kleieg/Duplo_Zug/images/Controller_white.jpeg

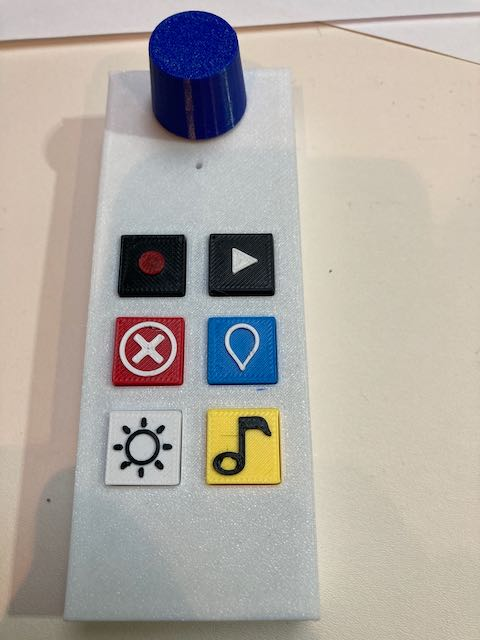
images/Controller_white.jpeg
