kleieg/Duplo_Zug/hardware/DuploTrainController NG/5 Buttons an ADC.xlsx

R0 | 2.2 | k |  | Rges in k | Rn in k | Uadc in V | Function | R E12 in k | Uadc in V | delta | ADC Value | Button
x1 | 0.15 |  | R1 | 0.4 | 0.4 | 0.495 | Record | 0.43 | 0.540 | 0.540 | 669.6882129 | Record
x2 | 0.3 |  | R2 | 0.9 | 0.6 | 0.99 | Play | 0.62 | 1.066 | 0.527 | 1323.323077 | Play
x3 | 0.45 |  | R3 | 1.8 | 0.9 | 1.485 | Stop | 0.91 | 1.555 | 0.489 | 1929.846154 | Stop
x4 | 0.6 |  | R4 | 3.3 | 1.5 | 1.98 | Water | 1.5 | 2.017 | 0.463 | 2503.915194 | Water
x5 | 0.75 |  | R5 | 6.6 | 3.3 | 2.475 | LED Cycle | 3.3 | 2.490 | 0.472 | 3090.285714 | Light
x6 | 0.9 |  | R5 | 19.8 | 13.2 | 2.97 | Sound Cycle | 13 | 2.969 | 0.480 | 3685.653916 | Sound
open |  |  |  |  |  | 3.3 | alle offen |  | 3.300 | 0.331 | 4096
 | Ucc | 3.3
 | Imax | 1mA
