kleieg/Duplo_Zug/hardware/DuploTrainController NG/DuploTrainController NG.csv

Id | Designator | Footprint | Quantity | Designation | Supplier and ref
1 | R5 | R_0805_2012Metric_Pad1.20x1.40mm_HandSolder | 1 | 1.5K
2 | R3 | R_0805_2012Metric_Pad1.20x1.40mm_HandSolder | 1 | 620
3 | R1 | R_0805_2012Metric_Pad1.20x1.40mm_HandSolder | 1 | 2,2k
4 | SW3 | SW_SPST_Omron_B3FS-101xP | 1 | Stop
5 | U1 | MODULE_ESP32-S3_SUPERMINI_SMD | 1 | ESP32-S3_SUPERMINI_SMD
6 | SW1 | SW_SPST_Omron_B3FS-101xP | 1 | Record
7 | SW0 | RotaryEncoder_Bourns_Vertical_PEC12R-3x17F-Sxxxx | 1 | Speed / Wakeup
8 | C1 | C_0805_2012Metric | 1 | 100n
9 | SW2 | SW_SPST_Omron_B3FS-101xP | 1 | Play
10 | R2 | R_0805_2012Metric_Pad1.20x1.40mm_HandSolder | 1 | 430
11 | R6 | R_0805_2012Metric_Pad1.20x1.40mm_HandSolder | 1 | 3.3k
12 | R4 | R_0805_2012Metric_Pad1.20x1.40mm_HandSolder | 1 | 910
13 | SW4 | SW_SPST_Omron_B3FS-101xP | 1 | Water
14 | SW6 | SW_SPST_Omron_B3FS-101xP | 1 | Sound Cycle
15 | SW5 | SW_SPST_Omron_B3FS-101xP | 1 | LED Cycle
16 | R7 | R_0805_2012Metric_Pad1.20x1.40mm_HandSolder | 1 | 13k
