kleieg/Duplo_Zug/hardware/Case/Controller-V1.5-Knöpfe-2.3mf

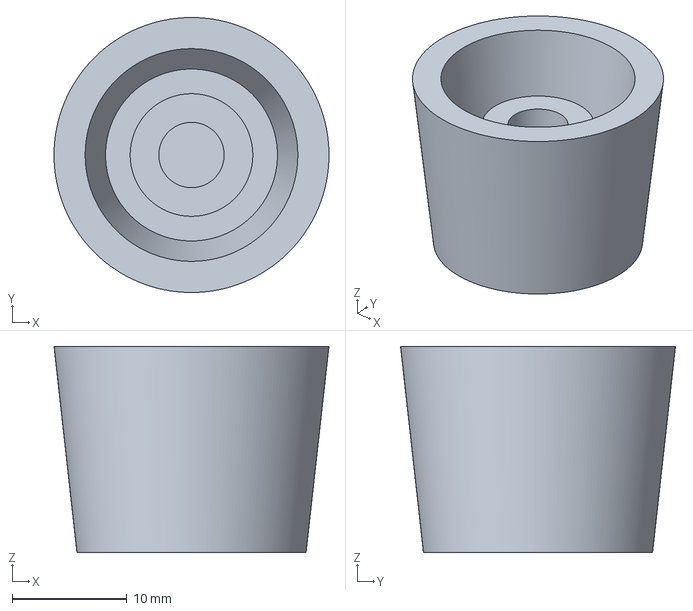
[picture p4: CAD file, 2026-03-19]
hardware/Case/Controller-V1.5-Knöpfe-2.3mf
24.0 x 24.0 x 18.0 mm
