kleieg/Duplo_Zug/hardware/Case/Controller-V1.5-Knöpfe-1.3mf

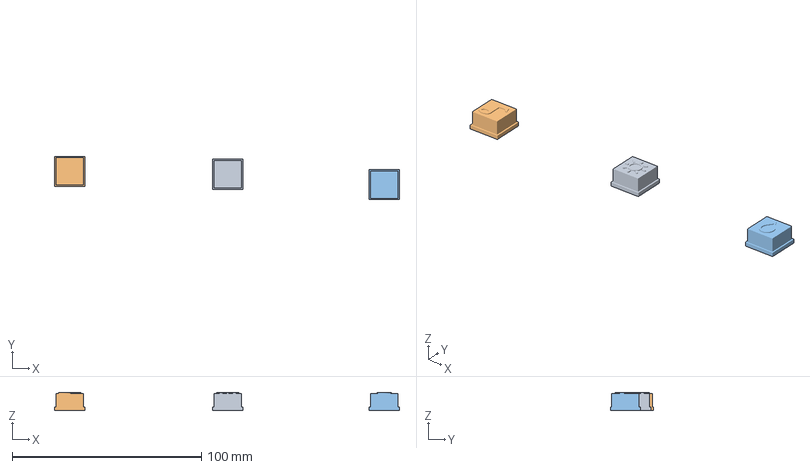
[picture p5: CAD file, 2026-03-19]
hardware/Case/Controller-V1.5-Knöpfe-1.3mf
182.4 x 23.0 x 9.59 mm
Knopf_Licht.stl
Knopf_Musik.stl
Knopf_Wasser.stl
