kleieg/Duplo_Zug/hardware/Case/Controller-V1.5-Duplo.3mf

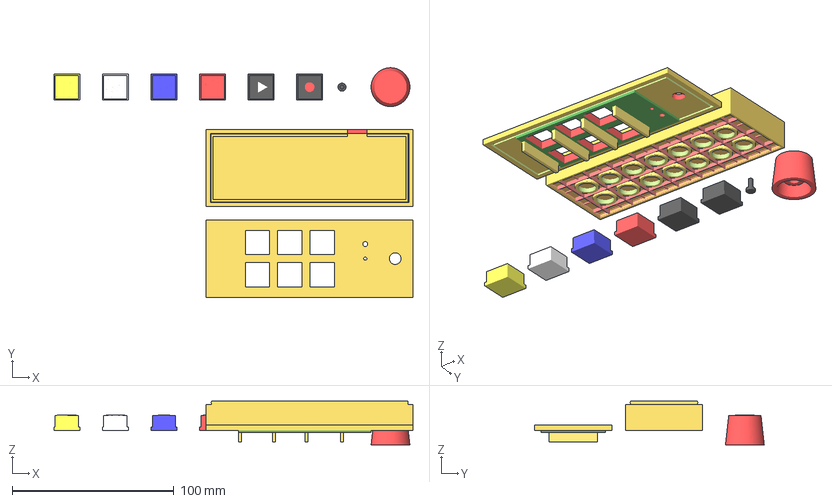
[picture p6: CAD file, 2026-03-19]
hardware/Case/Controller-V1.5-Duplo.3mf
221.9 x 141.9 x 27.0 mm
