kleieg/Duplo_Zug/hardware/Case/Controller-V1.5.3mf

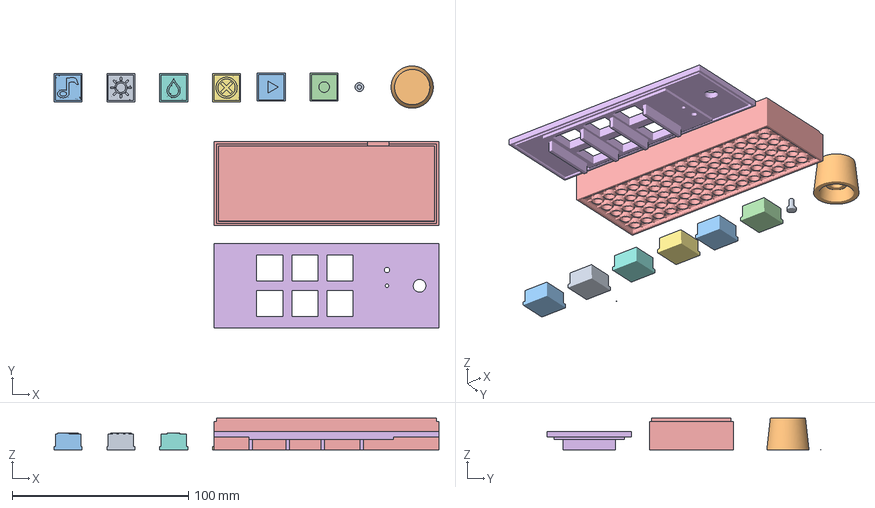
[picture p7: CAD file, 2026-03-08]
hardware/Case/Controller-V1.5.3mf
218.7 x 155.5 x 18.0 mm
