kleieg/Duplo_Zug/hardware/Case/Knopf_Wasser.stl

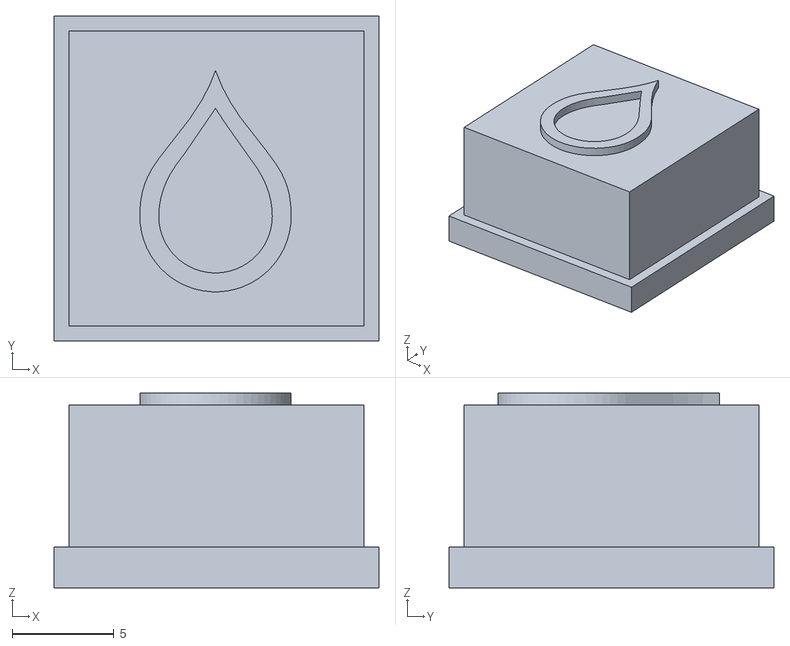
[picture p8: CAD file, 2026-03-08]
hardware/Case/Knopf_Wasser.stl
16.0 x 16.0 x 9.59
