kleieg/Duplo_Zug/hardware/Case/Knopf_Musik.stl

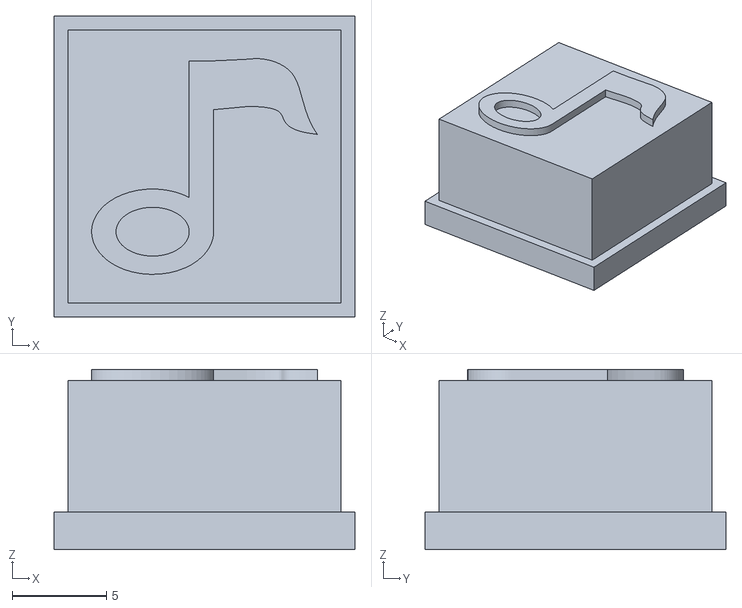
[picture p9: CAD file, 2026-03-08]
hardware/Case/Knopf_Musik.stl
16.0 x 16.0 x 9.58
