kleieg/Duplo_Zug/(list of files, cad)

Other CAD files:
hardware/Case/Knopf_Stop.stl
hardware/Case/Knopf_Licht.stl
hardware/Case/Controller.scad
