kleieg/Duplo_Zug/hardware/DuploTrainController NG/DuploTrainController NG.kicad_pcb

## KiCad design hardware/DuploTrainController NG/DuploTrainController NG.kicad_pcb (2026-03-08)

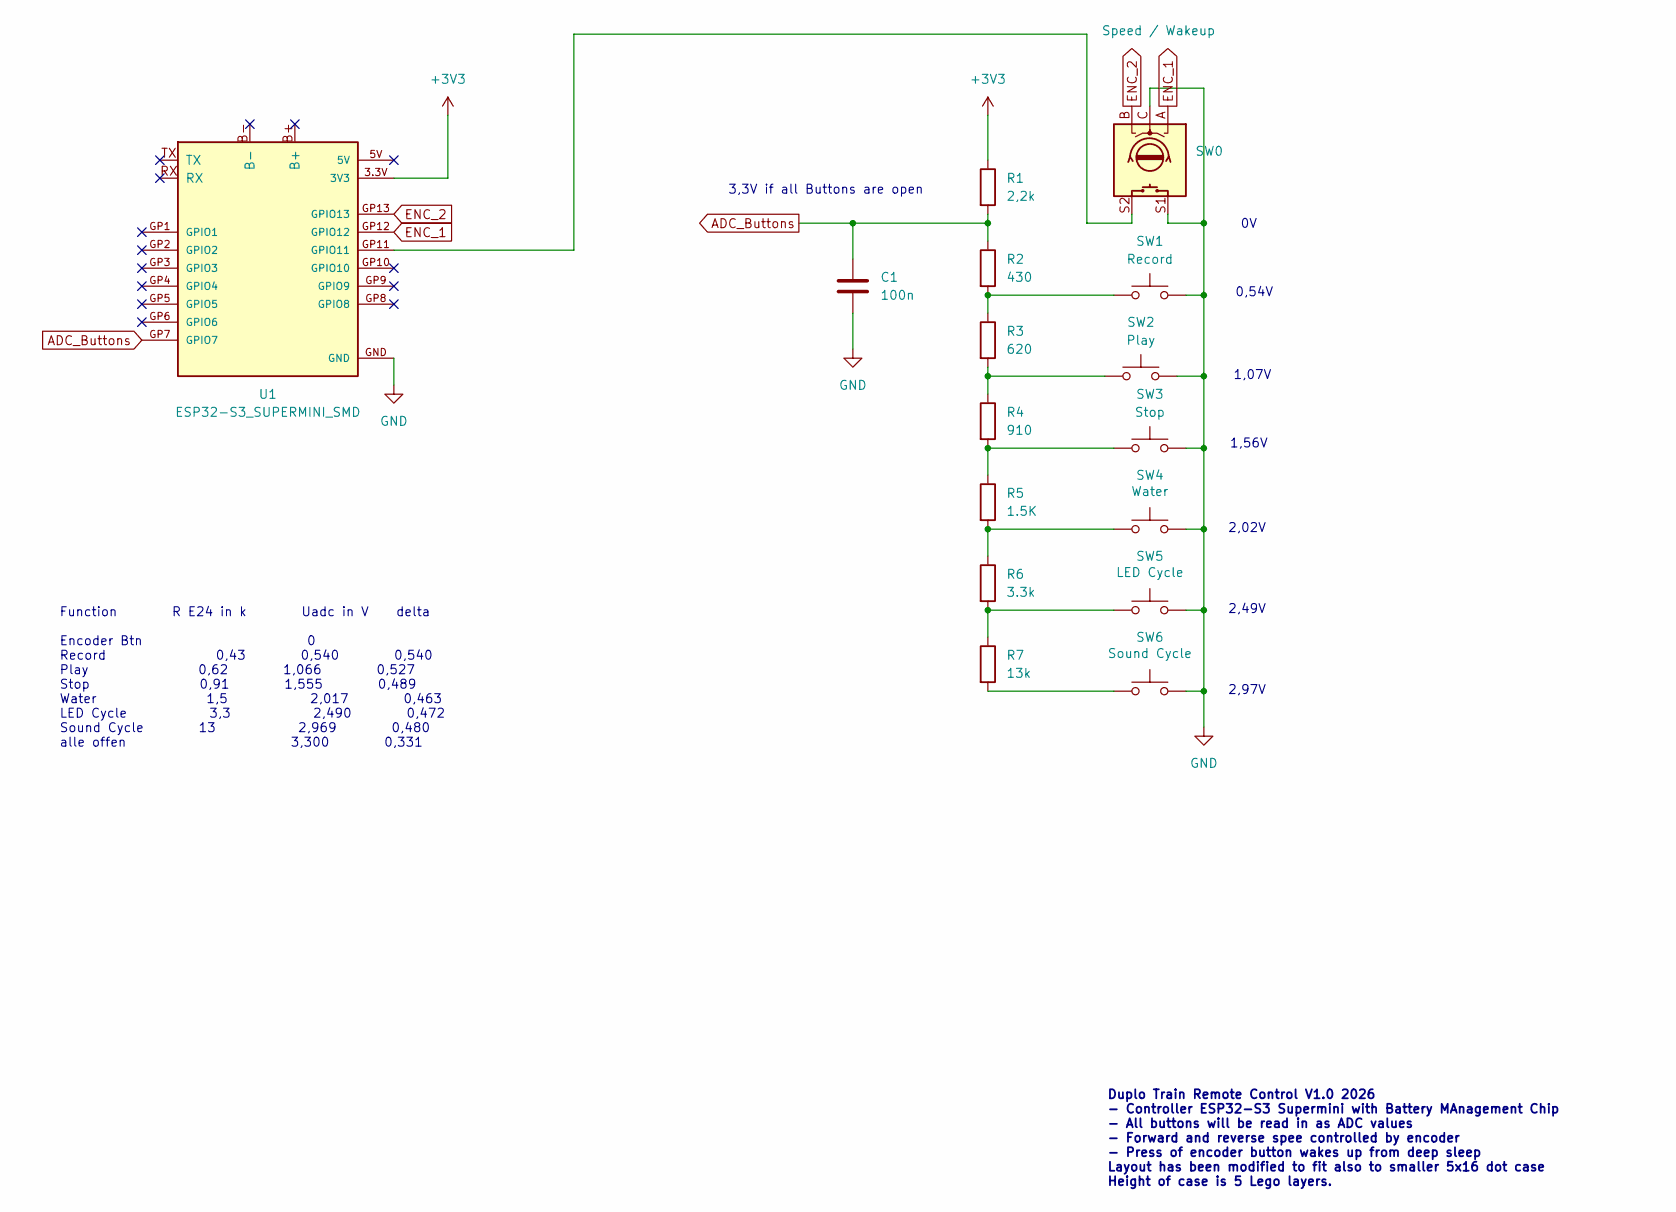
[picture p10: schematic DuploTrainController NG.kicad_sch]

Parts:
C1: 100n; C_0805_2012Metric
R1: 2,2k; R_0805_2012Metric_Pad1.20x1.40mm_HandSolder
R2: 430; R_0805_2012Metric_Pad1.20x1.40mm_HandSolder
R3: 620; R_0805_2012Metric_Pad1.20x1.40mm_HandSolder
R4: 910; R_0805_2012Metric_Pad1.20x1.40mm_HandSolder
R5: 1.5K; R_0805_2012Metric_Pad1.20x1.40mm_HandSolder
R6: 3.3k; R_0805_2012Metric_Pad1.20x1.40mm_HandSolder
R7: 13k; R_0805_2012Metric_Pad1.20x1.40mm_HandSolder
SW0: Speed / Wakeup; RotaryEncoder_Bourns_Vertical_PEC12R-3x17F-Sxxxx
SW1: Record; SW_SPST_Omron_B3FS-101xP
SW2: Play; SW_SPST_Omron_B3FS-101xP
SW3: Stop; SW_SPST_Omron_B3FS-101xP
SW4: Water; SW_SPST_Omron_B3FS-101xP
SW5: LED Cycle; SW_SPST_Omron_B3FS-101xP
SW6: Sound Cycle; SW_SPST_Omron_B3FS-101xP
U1: ESP32-S3_SUPERMINI_SMD; MODULE_ESP32-S3_SUPERMINI_SMD

Connections:
+3V3: R1.1, U1.3.3V (3V3)
ADC_Buttons: C1.1, R1.2, R2.1, U1.GP7 (GPIO7)
ENC_1: SW0.A, U1.GP12 (GPIO12)
ENC_2: SW0.B, U1.GP13 (GPIO13)
GND: C1.2, SW0.C, SW0.S1, SW1.2, SW2.2, SW3.2, SW4.2, SW5.2, SW6.2, U1.GND
unnamed: R2.2, R3.1, SW1.1
unnamed: R3.2, R4.1, SW2.1
unnamed: R4.2, R5.1, SW3.1
unnamed: R5.2, R6.1, SW4.1
unnamed: R6.2, R7.1, SW5.1
unnamed: R7.2, SW6.1
unnamed: SW0.S2, U1.GP11 (GPIO11)

Notes on the sheet:
2,02V
0,54V
2,49V
1,07V
Duplo Train Remote Control V1.0 2026 - Controller ESP32-S3 Supermini with Battery MAnagement Chip - All buttons will be read in as ADC values - Forward and reverse spee controlled by encoder - Press of encoder button wakes up from deep sleep Layout has been modified to fit also to smaller 5x16 dot 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
3,3V if all Buttons are open
2,97V
Function R E24 in k Uadc in V delta Encoder Btn 0 Record 0,43 0,540 0,540 Play 0,62 1,066 0,527 Stop 0,91 1,555 0,489 Water 1,5 2,017 0,463 LED Cycle 3,3 2,490 0,472 Sound Cycle 13 2,969 0,480 alle offen 3,300 0,331
1,56V

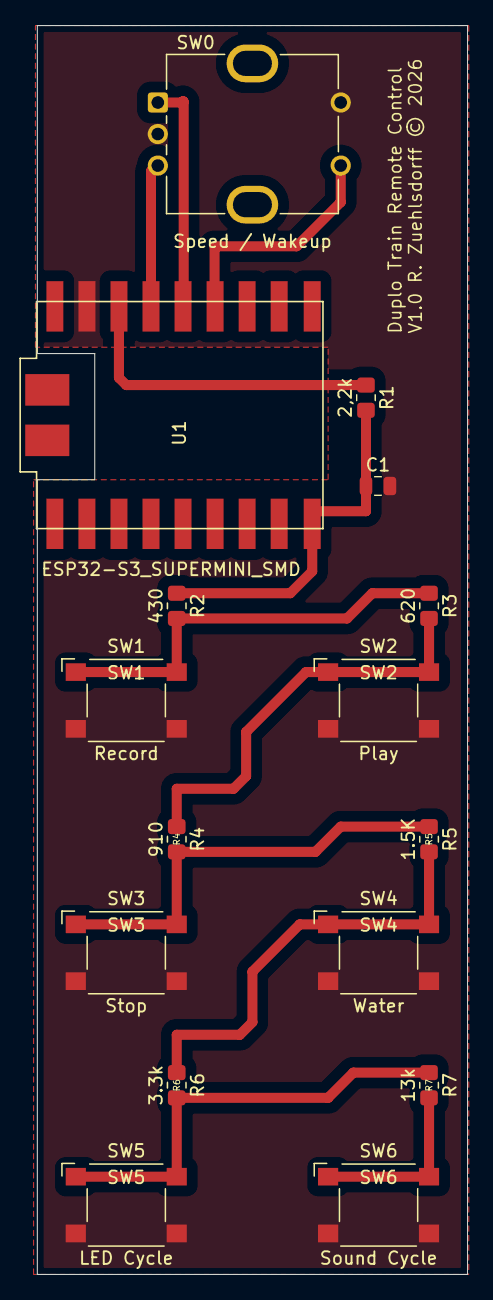
[picture p11: board DuploTrainController NG.kicad_pcb from above]

Board: 2 copper layers, 34.1 x 99.0 mm, 16 parts (0 on the bottom side), 12 nets.
