kleieg/Duplo_Zug/src/DuploHub.cpp

/**
 * @file DuploHub.cpp
 * @brief Implementation of the DuploHub class for LEGO DUPLO Train Hub control on ESP32.
 *
 * This file provides the implementation for the DuploHub class, which encapsulates all
 * functionality required to control a LEGO DUPLO Train Hub using the ESP32 platform.
 *
 * Features:
 * - Thread-safe command queuing for motor, LED, and sound control
 * - Optimized BLE task responsiveness and reduced latency
 * - Automatic connection management and recovery
 * - Dual-core FreeRTOS architecture for robust, responsive operation
 * - Modular callback system for sensors and events
 *
 * @author Ralf Zühlsdorff
 * @date 2025
 *
 * @copyright
 * MIT License
 *
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
 * THE SOFTWARE IS PROVIDED "AS IS", WITHOUT WARRANTY OF ANY KIND, EXPRESS OR
 * IMPLIED, INCLUDING BUT NOT LIMITED TO THE WARRANTIES OF MERCHANTABILITY,
 * FITNESS FOR A PARTICULAR PURPOSE AND NONINFRINGEMENT. IN NO EVENT SHALL THE
 * AUTHORS OR COPYRIGHT HOLDERS BE LIABLE FOR ANY CLAIM, DAMAGES OR OTHER
 * LIABILITY, WHETHER IN AN ACTION OF CONTRACT, TORT OR OTHERWISE, ARISING FROM,
 * OUT OF OR IN CONNECTION WITH THE SOFTWARE OR THE USE OR OTHER DEALINGS IN THE
 * SOFTWARE.
 */

#include "Arduino.h"
#include "DuploHub.h"
#include "LegoinoCommon.h"
#include "esp_timer.h"
#include "esp_err.h"
#include "esp_task_wdt.h"

//  #define DEBUG // Enable debug logging
#undef DEBUG // Enable debug logging
#include "debug.h"

// Initialize static instance pointer
DuploHub *DuploHub::instance = nullptr;

namespace
{
    // Color must stay unchanged this long before it is reported. Short enough that a tile is
    // registered at full speed (was 250 ms: tiles were missed and reactions came too late);
    // increase if reflective surfaces cause false tile detections.
    constexpr uint64_t COLOR_SETTLE_DELAY_US = 80000; // 80 ms debounce window
    // Color sensor input mode: 0 = COLOR (classifies any surface into a color index, also carpet,
    // floor, nothing), 1 = C TAG ("color tag", presumably the hub's own action tile detection).
    // C TAG reports one event per action tile (color, then 0xff) and nothing on carpet/floor, so
    // it is far more robust; its events bypass the debounce (see staticColorSensorCallback()).
    // 0 restores the plain COLOR mode with the debounce.
    constexpr uint8_t COLOR_SENSOR_MODE = 1;
    // TEST diagnostics: log every raw color sensor message and what the debounce emits or
    // suppresses (same color as the last stable one). Set to false to disable.
    constexpr bool COLOR_RAW_DIAG = false;
    // The DUPLO hub silently drops a command that arrives while it is still processing the
    // previous one (seen on hardware with 20 ms spacing: random loss of stop/sound/LED commands
    // and sensor activations). Normally the BLE task waits for the hub's acknowledgement
    // (see processCommandQueue()); this fixed pause only applies to commands the hub never
    // acknowledges (hub name) and to unknown/skipped commands.
    constexpr uint32_t COMMAND_PACING_MS = 200;
    // Maximum wait for the hub's acknowledgement of a command (observed: 40-110 ms). After the
    // timeout the BLE task continues, so it is never slower than the fixed pacing.
    constexpr uint32_t ACK_TIMEOUT_MS = 250;
    // Maximum time the BLE task waits for a new command before doing its housekeeping.
    constexpr uint32_t COMMAND_WAIT_MS = 50;
    // After connecting, the hub announces its built-in devices one by one. A device must be
    // announced before it can be activated (Legoino silently ignores unknown ports).
    constexpr uint32_t DEVICE_ATTACH_TIMEOUT_MS = 2000;
    constexpr uint32_t BLE_TASK_WDT_TIMEOUT_S = 15;    // task watchdog timeout for the BLE task
    constexpr UBaseType_t COMMAND_QUEUE_LENGTH = 10;   // main loop -> BLE task
    constexpr UBaseType_t RESPONSE_QUEUE_LENGTH = 100; // BLE task -> main loop (sensor bursts)

    /**
     * @brief Build a timestamped command object for the BLE worker queue.
     * @param type Command type to assign to the new queue item.
     * @return Initialized `HubCommand` containing the current timestamp.
     */
    HubCommand createHubCommand(CommandType type)
    {
        HubCommand cmd{};
        cmd.type = type;
        cmd.timestamp = esp_timer_get_time();
        return cmd;
    }

    // Shared state used to debounce the color sensor callback before emitting events
    portMUX_TYPE colorTimerMutex = portMUX_INITIALIZER_UNLOCKED;
    esp_timer_handle_t colorStabilityTimer = nullptr;
    int pendingColor = -1;
    int pendingRawColor = -1;
    int lastStableColor = -1;
}

/**
 * @brief Create the color stability debounce timer on first use.
 *
 * The timer delays emission of color sensor events by `COLOR_SETTLE_DELAY_US`, ensuring that only
 * stable readings reach the main application. The function is safe to call repeatedly; it merely
 * returns once initialization has succeeded.
 *
 * @return True when the timer handle exists and can be armed.
 */
bool DuploHub::ensureColorTimerInitialized()
{
    if (colorStabilityTimer != nullptr)
    {
        return true;
    }

    DEBUG_LOG("Created color stability timer ");
    esp_timer_create_args_t timerArgs = {};
    timerArgs.callback = &DuploHub::colorStabilityTimerCallback;
    timerArgs.dispatch_method = ESP_TIMER_TASK;
    timerArgs.name = "color_stability";
    timerArgs.skip_unhandled_events = true;

    esp_err_t err = esp_timer_create(&timerArgs, &colorStabilityTimer);
    if (err != ESP_OK)
    {
        DEBUG_LOG("ERROR: Failed to create color stability timer (err=%d)", err);
        colorStabilityTimer = nullptr;
        return false;
    }

    return true;
}

/**
 * @brief Default constructor for DuploHub.
 *
 * Resets all state variables. The motor is always driven on the DUPLO `MOTOR` port.
 */
DuploHub::DuploHub() : hubMACAddress(""),
                       connectionState(false), connectingState(false),
                       connectionMutex(nullptr), commandQueue(nullptr), responseQueue(nullptr),
                       bleTaskHandle(nullptr),
                       onConnectedCallback(nullptr), onDisconnectedCallback(nullptr),
                       detectedColorCallback(nullptr), detectedSpeedCallback(nullptr),
                       detectedVoltageCallback(nullptr)
{
    instance = this; // Set static instance pointer
}

/**
 * @brief Destructor for DuploHub.
 *
 * Cleans up FreeRTOS resources and resets the static instance pointer.
 */
DuploHub::~DuploHub()
{
    cleanupFreeRTOS();
    if (instance == this)
    {
        instance = nullptr; // Clear static instance pointer
    }
}

/**
 * @brief Initialize FreeRTOS objects (mutexes and queues) for thread-safe operation.
 *
 * Creates mutexes and queues for command and response handling.
 */
void DuploHub::initFreeRTOS()
{
    // Create mutex for thread-safe access to connection state
    connectionMutex = xSemaphoreCreateMutex();
    if (connectionMutex == nullptr)
    {
        DEBUG_LOG("ERROR: Failed to create connection mutex");
    }

    // Create command queue for thread-safe communication
    ackSemaphore = xSemaphoreCreateBinary();
    if (ackSemaphore == nullptr)
    {
        DEBUG_LOG("ERROR: Failed to create acknowledgement semaphore");
    }

    commandQueue = xQueueCreate(COMMAND_QUEUE_LENGTH, sizeof(HubCommand));
    if (commandQueue == nullptr)
    {
        DEBUG_LOG("ERROR: Failed to create command queue");
    }

    responseQueue = xQueueCreate(RESPONSE_QUEUE_LENGTH, sizeof(HubResponse));
    if (responseQueue == nullptr)
    {
        DEBUG_LOG("ERROR: Failed to create response queue");
    }

    DEBUG_LOG("DuploHub: FreeRTOS objects initialized");
}

/**
 * @brief Clean up FreeRTOS objects (mutexes and queues).
 *
 * Deletes all created mutexes and queues and stops the BLE task if running.
 */
void DuploHub::cleanupFreeRTOS()
{
    // Stop BLE task if running
    stopBLETask();

    // Delete mutex
    if (connectionMutex != nullptr)
    {
        vSemaphoreDelete(connectionMutex);
        connectionMutex = nullptr;
    }

    if (ackSemaphore != nullptr)
    {
        vSemaphoreDelete(ackSemaphore);
        ackSemaphore = nullptr;
    }

    // Delete command queue
    if (commandQueue != nullptr)
    {
        vQueueDelete(commandQueue);
        commandQueue = nullptr;
        DEBUG_LOG("DuploHub: Command queue cleaned up");
    }

    // Cleanup response queue
    if (responseQueue != nullptr)
    {
        vQueueDelete(responseQueue);
        responseQueue = nullptr;
        DEBUG_LOG("DuploHub: Response queue cleaned up");
    }

    DEBUG_LOG("DuploHub: FreeRTOS objects cleaned up");
}

/**
 * @brief Update the connection state variables in a thread-safe manner.
 * @param connected True if the hub is connected.
 * @param connecting True if the hub is in the process of connecting.
 */
void DuploHub::updateConnectionState(bool connected, bool connecting)
{
    if (connectionMutex != nullptr)
    {
        xSemaphoreTake(connectionMutex, portMAX_DELAY);
        connectionState = connected;
        connectingState = connecting;
        xSemaphoreGive(connectionMutex);
    }
}

/**
 * @brief Initialize the DuploHub (thread-safe, can be called from main loop).
 *
 * Sets up FreeRTOS resources and starts the BLE task.
 */
void DuploHub::init()
{
    DEBUG_LOG("DuploHub: Initializing ...");
    initFreeRTOS();
    delay(500);
    startBLETask();
    delay(500);
    DEBUG_LOG("DuploHub: Initialization complete");
}

/**
 * @brief Initialize the DuploHub with a specific BLE address (not recommended).
 * @param address The BLE address to use for the hub.
 *
 * Note: BLE task handles initialization; this is for future use.
 */
void DuploHub::init(const std::string &address)
{
    DEBUG_LOG("WARNING: init(address) should not be called directly - BLE task handles initialization");
    hubMACAddress = address;
    init();
}

/**
 * @brief Check if the hub is connected (thread-safe).
 * @return True if connected, false otherwise.
 */
bool DuploHub::isConnected()
{
    if (connectionMutex != nullptr)
    {
        xSemaphoreTake(connectionMutex, portMAX_DELAY);
        bool state = connectionState;
        xSemaphoreGive(connectionMutex);
        return state;
    }
    return hub.isConnected(); // Fallback if mutex not initialized
}

/**
 * @brief Check if the hub is currently connecting (thread-safe).
 * @return True if connecting, false otherwise.
 */
bool DuploHub::isConnecting()
{
    if (connectionMutex != nullptr)
    {
        xSemaphoreTake(connectionMutex, portMAX_DELAY);
        bool state = connectingState;
        xSemaphoreGive(connectionMutex);
        return state;
    }
    return hub.isConnecting(); // Fallback if mutex not initialized
}

/**
 * @brief Check if the hub is disconnected (thread-safe).
 * @return True if disconnected, false otherwise.
 */
bool DuploHub::isDisconnected()
{
    return !isConnecting() && !isConnected();
}

/**
 * @brief Get the BLE address of the hub.
 * @return The hub's BLE address as a string.
 */
std::string DuploHub::getHubAddress()
{
    return hub.getHubAddress().toString();
}

/**
 * @brief Get the name of the hub.
 * @return The hub's name as a string.
 */
std::string DuploHub::getHubName()
{
    return hub.getHubName();
}

/**
 * @brief Enable or disable command recording
 * @param enable True to start recording commands, false to stop
 */
void DuploHub::recordCommands(bool enable)
{
    recordCommandsEnabled = enable;
    if (enable)
    {
        commandBufferCount = 0;
        DEBUG_LOG("DuploHub: Command recording ENABLED. Fixed buffer (%zu) cleared.", COMMAND_BUFFER_CAPACITY);
    }
    else
    {
        DEBUG_LOG("DuploHub: Command recording DISABLED. Buffer contains %zu commands.", commandBufferCount);
    }
}

/**
 * @brief Start replaying all previously recorded commands with normalized timestamps
 * The first command timestamp is set to 0 and all other timestamps are adjusted
 * to maintain relative timing differences
 */
void DuploHub::replayCommands()
{
    if (commandBufferCount == 0)
    {
        DEBUG_LOG("DuploHub: No commands to replay. Buffer is empty.");
        return;
    }

    if (replaying)
    {
        DEBUG_LOG("DuploHub: Replay already in progress. Stopping current replay first.");
        stopReplay();
    }

    recordCommandsEnabled = false;

    // Normalize timestamps so replay compares only elapsed time since replay start.
    if (commandBufferCount > 0)
    {
        originalStartTime = commandBuffer[0].timestamp;

        for (size_t i = 0; i < commandBufferCount; ++i)
        {
            commandBuffer[i].timestamp -= originalStartTime; // Normalize to start at 0
        }

        DEBUG_LOG("DuploHub: Normalized %zu commands. Sequence duration: %lld us", commandBufferCount,
                  commandBuffer[commandBufferCount - 1].timestamp);
    }

    // Initialize replay state
    replaying = true;
    replayIndex = 0;
    replayStartTime = esp_timer_get_time();

    DEBUG_LOG("DuploHub: Started replay of %zu recorded commands. Use getNextReplayCommand() to retrieve commands.", commandBufferCount);
}

/**
 * @brief Get the next command to replay if it's time to execute it
 * @return Pointer to the next command if ready, nullptr if no command ready or replay finished
 */
const HubCommand *DuploHub::getNextReplayCommand()
{
    if (!replaying || commandBufferCount == 0)
    {
        return nullptr;
    }

    uint64_t currentTime = esp_timer_get_time();
    uint64_t totalElapsedTime = currentTime - replayStartTime;

    // Only play the sequence ONCE
    if (replayIndex >= commandBufferCount)
    {
        // End of sequence reached, stop replay
        DEBUG_LOG("DuploHub: Replay finished after one sequence");
        stopReplay();
        return nullptr;
    }

    const HubCommand &nextCmd = commandBuffer[replayIndex];
    if ((int64_t)totalElapsedTime >= nextCmd.timestamp)
    {
        replayIndex++;
        DEBUG_LOG("DuploHub: Retrieved replay command %zu/%zu (type: %d) time: %llu us",
                  replayIndex, commandBufferCount, nextCmd.type, totalElapsedTime);
        return &nextCmd;
    }
    return nullptr; // Not yet time to play this command
}

/**
 * @brief Check if command replay is currently active
 * @return true if replay is in progress, false otherwise
 */
bool DuploHub::isReplayActive() const
{
    return replaying;
}

/**
 * @brief Report whether command recording is currently enabled.
 * @return `true` when outgoing commands are being captured for replay.
 */
bool DuploHub::isRecordingCommandsEnabled() const
{
    return recordCommandsEnabled;
}

/**
 * @brief Stop the current command replay
 */
void DuploHub::stopReplay()
{
    if (replaying)
    {
        DEBUG_LOG("DuploHub: Stopping replay at command %zu/%zu", replayIndex, commandBufferCount);
        replaying = false;
        replayIndex = 0;
        replayStartTime = 0;
    }
    else
    {
        DEBUG_LOG("DuploHub: No active replay to stop.");
    }
}

/**
 * @brief Wrapper around xQueueSend that optionally records commands to commandBuffer
 * @param cmd The command to send and optionally record
 * @param timeout Timeout for queue send operation
 * @return Result of xQueueSend operation
 */
BaseType_t DuploHub::sendCommand(const HubCommand &cmd, TickType_t timeout)
{
    // Record the queue payload before sending so replay uses the exact original command sequence.
    if (recordCommandsEnabled)
    {
        if (commandBufferCount < COMMAND_BUFFER_CAPACITY)
        {
            commandBuffer[commandBufferCount++] = cmd;
            DEBUG_LOG("DuploHub: Command %d recorded to buffer. Buffer size: %zu/%zu", cmd.type, commandBufferCount, COMMAND_BUFFER_CAPACITY);

            if (commandBufferCount >= COMMAND_BUFFER_CAPACITY)
            {
                recordCommandsEnabled = false;
                DEBUG_LOG("DuploHub: Command buffer full (%zu). Recording stopped automatically.", COMMAND_BUFFER_CAPACITY);
            }
        }
        else
        {
            recordCommandsEnabled = false;
            DEBUG_LOG("DuploHub: Command buffer already full (%zu). Recording remains stopped.", COMMAND_BUFFER_CAPACITY);
        }
    }

    // Actual command execution is deferred to the BLE worker task.
    return xQueueSend(commandQueue, &cmd, timeout);
}

/**
 * @brief Queue a command for the BLE task, logging failures (thread-safe).
 * @param cmd Command to queue (recorded for replay while recording is enabled).
 * @param what Short description used in log messages.
 */
void DuploHub::queueCommand(const HubCommand &cmd, const char *what)
{
    if (commandQueue == nullptr)
    {
        DEBUG_LOG("ERROR: Command queue is not initialized - cannot %s", what);
        return;
    }

    if (sendCommand(cmd, pdMS_TO_TICKS(100)) != pdTRUE)
    {
        DEBUG_LOG("WARNING: Failed to queue %s command", what);
    }
}

/**
 * @brief Queue a previously recorded command again (used by replay).
 * @param cmd Recorded command to execute.
 */
void DuploHub::replayCommand(const HubCommand &cmd)
{
    queueCommand(cmd, "replay");
}

/**
 * @brief Set the hub's name (thread-safe).
 * @param name The new name for the hub.
 */
void DuploHub::setHubName(const char *name)
{
    HubCommand cmd = createHubCommand(CommandType::CMD_SET_HUB_NAME);
    strncpy(cmd.data.hubName.name, name, sizeof(cmd.data.hubName.name) - 1);
    cmd.data.hubName.name[sizeof(cmd.data.hubName.name) - 1] = '\0'; // Ensure null termination
    queueCommand(cmd, "hub name");
}

/**
 * @brief Set the LED color on the hub (thread-safe).
 * @param color The color to set (DuploEnums::DuploColor).
 */
void DuploHub::setLedColor(DuploEnums::DuploColor color)
{
    HubCommand cmd = createHubCommand(CommandType::CMD_SET_LED_COLOR);
    cmd.data.led.color = color;
    queueCommand(cmd, "LED color");
}

/**
 * @brief Set the motor speed (thread-safe).
 * @param speed The speed to set for the motor.
 */
void DuploHub::setMotorSpeed(int speed)
{
    HubCommand cmd = createHubCommand(CommandType::CMD_MOTOR_SPEED);
    cmd.data.motor.speed = speed;
    queueCommand(cmd, "motor speed");
}

/**
 * @brief Stop the motor (thread-safe).
 */
void DuploHub::stopMotor()
{
    queueCommand(createHubCommand(CommandType::CMD_STOP_MOTOR), "stop motor");
}

/**
 * @brief Play a sound on the Duplo Hub (thread-safe).
 * @param soundId The ID of the sound to play.
 */
void DuploHub::playSound(int soundId)
{
    HubCommand cmd = createHubCommand(CommandType::CMD_PLAY_SOUND);
    cmd.data.sound.soundId = soundId;
    queueCommand(cmd, "play sound");
}

/**
 * @brief Activate the RGB light on the hub (thread-safe).
 */
void DuploHub::activateRgbLight()
{
    queueCommand(createHubCommand(CommandType::CMD_ACTIVATE_RGB_LIGHT), "activate RGB light");
}

/**
 * @brief Activate the base speaker on the hub (thread-safe).
 */
void DuploHub::activateBaseSpeaker()
{
    queueCommand(createHubCommand(CommandType::CMD_ACTIVATE_BASE_SPEAKER), "activate base speaker");
}

/**
 * @brief Activate the color sensor on the hub (thread-safe).
 */
void DuploHub::activateColorSensor()
{
    queueCommand(createHubCommand(CommandType::CMD_ACTIVATE_COLOR_SENSOR), "activate color sensor");
}

/**
 * @brief Activate the speed sensor on the hub (thread-safe).
 */
void DuploHub::activateSpeedSensor()
{
    queueCommand(createHubCommand(CommandType::CMD_ACTIVATE_SPEED_SENSOR), "activate speed sensor");
}

/**
 * @brief Activate the voltage sensor on the hub (thread-safe).
 */
void DuploHub::activateVoltageSensor()
{
    queueCommand(createHubCommand(CommandType::CMD_ACTIVATE_VOLTAGE_SENSOR), "activate voltage sensor");
}

/**
 * @brief Static callback for color sensor events (used by activatePortDevice).
 * @param hub Pointer to the hub instance.
 * @param portNumber The port number of the sensor.
 * @param deviceType The type of device triggering the callback.
 * @param pData Pointer to the sensor data.
 */
void DuploHub::staticColorSensorCallback(void *hub, byte portNumber, DeviceType deviceType, uint8_t *pData)
{
    myLegoHub *myHub = (myLegoHub *)hub;
    (void)portNumber;

    if (deviceType != DeviceType::DUPLO_TRAIN_BASE_COLOR_SENSOR)
    {
        DEBUG_LOG("ERROR: Unsupported device type for color sensor callback");
        return;
    }

    int detectedColor = myHub->parseColor(pData);

    if (COLOR_RAW_DIAG)
    {
        char line[96];
        int pos = snprintf(line, sizeof(line), "[COLOR RAW %lu]", millis());
        const int length = pData[0];
        for (int i = 0; i < length && pos < (int)sizeof(line) - 16; i++)
        {
            pos += snprintf(line + pos, sizeof(line) - pos, " %02x", pData[i]);
        }
        snprintf(line + pos, sizeof(line) - pos, "  -> color %d", detectedColor);
        Serial.println(line);
    }

    if (detectedColor < DuploEnums::DuploColor::BLACK || detectedColor > DuploEnums::DuploColor::WHITE)
    {
        return; // Ignore out-of-range values entirely (C TAG: 0xff = end of tag)
    }

    // C TAG mode sends one discrete event per tile (tag color, then 0xff), nothing in between:
    // emit it immediately. No debounce and no "same as last color" filter, otherwise two tiles of
    // the same color in a row would be swallowed. COLOR mode needs the debounce below.
    if (COLOR_SENSOR_MODE == 1 || !ensureColorTimerInitialized())
    {
        // Emit immediately (C TAG event, or fallback if the debounce timer could not be created)
        if (instance != nullptr && instance->responseQueue != nullptr)
        {
            HubResponse response;
            response.type = ResponseType::Detected_Color;
            response.data.colorResponse.detectedColor = (DuploEnums::DuploColor)detectedColor;

            if (xQueueSend(instance->responseQueue, &response, pdMS_TO_TICKS(100)) != pdTRUE)
            {
                DEBUG_LOG("WARNING: Failed to queue color sensor response from static callback (timer init failure)");
            }
        }
        else
        {
            DEBUG_LOG("ERROR: Cannot access response queue from static color callback (timer init failure)");
        }
        return;
    }

    bool timerActive = esp_timer_is_active(colorStabilityTimer);
    bool restartTimer = false;

    // Store latest candidate color and only restart settling timer when something changed
    portENTER_CRITICAL(&colorTimerMutex);
    if (pendingColor != detectedColor)
    {
        pendingColor = detectedColor;
        pendingRawColor = pData[4];
        restartTimer = true;
    }
    else if (!timerActive)
    {
        // Timer already expired; ensure we arm it again to confirm stability
        pendingRawColor = pData[4];
        restartTimer = true;
    }
    portEXIT_CRITICAL(&colorTimerMutex);

    if (restartTimer)
    {
        esp_err_t stopErr = esp_timer_stop(colorStabilityTimer);
        if (stopErr != ESP_OK && stopErr != ESP_ERR_INVALID_STATE)
        {
            DEBUG_LOG("WARNING: Failed to stop color stability timer (err=%d)", stopErr);
        }

        esp_err_t startErr = esp_timer_start_once(colorStabilityTimer, COLOR_SETTLE_DELAY_US);
        if (startErr != ESP_OK)
        {
            DEBUG_LOG("ERROR: Failed to start color stability timer (err=%d)", startErr);
        }
    }
}
/**
 * @brief Timer hook that emits a stabilized color reading to the response queue.
 *
 * Invoked on the ESP timer task context after the debounce interval elapses. If the color sample
 * remains unchanged since the last stable notification, no queue message is produced.
 *
 * @param arg Unused. Present to satisfy the timer callback signature.
 */
void DuploHub::colorStabilityTimerCallback(void *arg)
{
    (void)arg;

    int colorToEmit = -1;
    int rawColorToEmit = -1;
    int suppressedColor = -1;
    portENTER_CRITICAL(&colorTimerMutex);
    if (pendingColor >= DuploEnums::DuploColor::BLACK && pendingColor <= DuploEnums::DuploColor::WHITE)
    {
        if (pendingColor != lastStableColor)
        {
            colorToEmit = pendingColor;
            rawColorToEmit = pendingRawColor;
            lastStableColor = pendingColor;
        }
        else
        {
            suppressedColor = pendingColor;
        }
    }

    pendingColor = -1;
    pendingRawColor = -1;
    portEXIT_CRITICAL(&colorTimerMutex);

    if (COLOR_RAW_DIAG)
    {
        if (colorToEmit != -1)
        {
            Serial.printf("[COLOR STABLE %lu] emit color %d\n", millis(), colorToEmit);
        }
        else if (suppressedColor != -1)
        {
            Serial.printf("[COLOR STABLE %lu] suppressed color %d (same as last stable)\n", millis(), suppressedColor);
        }
    }

    if (colorToEmit == -1)
    {
        return;
    }

    DEBUG_LOG("(%ld) Static Color Callback - Stable Color: raw=%d parsed=%d", millis(), rawColorToEmit, colorToEmit);

    if (instance != nullptr && instance->responseQueue != nullptr)
    {
        HubResponse response;
        response.type = ResponseType::Detected_Color;
        response.data.colorResponse.detectedColor = (DuploEnums::DuploColor)colorToEmit;

        if (xQueueSend(instance->responseQueue, &response, pdMS_TO_TICKS(100)) != pdTRUE)
        {
            DEBUG_LOG("WARNING: Failed to queue color sensor response from stability timer");
        }
    }
    else
    {
        DEBUG_LOG("ERROR: Cannot access response queue from color stability timer");
    }
}

/**
 * @brief Static callback for speed sensor events (used by activatePortDevice).
 * @param hub Pointer to the hub instance.
 * @param portNumber The port number of the sensor.
 * @param deviceType The type of device triggering the callback.
 * @param pData Pointer to the sensor data.
 */
void DuploHub::staticSpeedSensorCallback(void *hub, byte portNumber, DeviceType deviceType, uint8_t *pData)
{
    static int lastSpeed = -1;

    myLegoHub *myHub = (myLegoHub *)hub;
    if (deviceType == DeviceType::DUPLO_TRAIN_BASE_SPEEDOMETER)
    {
        int detectedSpeed = myHub->parseSpeedometer(pData);
        if (abs(lastSpeed - detectedSpeed) > SPEED_THRESHOLD)
        { // Only report significant speed changes
            DEBUG_LOG("(%ld) Static Speed Callback - Last Speed: %d , Detected Speed: %d", millis(), lastSpeed, detectedSpeed);
            lastSpeed = detectedSpeed;

            // Access the singleton instance to get the response queue
            if (instance != nullptr && instance->responseQueue != nullptr)
            {
                HubResponse response;
                response.type = ResponseType::Detected_Speed;
                response.data.speedResponse.detectedSpeed = myHub->MapSpeedometer(detectedSpeed);

                if (xQueueSend(instance->responseQueue, &response, pdMS_TO_TICKS(100)) != pdTRUE)
                {
                    DEBUG_LOG("WARNING: Failed to queue speed sensor response from static callback");
                }
            }
            else
            {
                DEBUG_LOG("ERROR: Cannot access response queue from static speed callback");
            }
        }
    }
    else
    {
        DEBUG_LOG("ERROR: Unsupported device type for speed sensor callback");
    }
}

/**
 * @brief Static callback for voltage sensor events (used by activatePortDevice).
 * @param hub Pointer to the hub instance.
 * @param portNumber The port number of the sensor.
 * @param deviceType The type of device triggering the callback.
 * @param pData Pointer to the sensor data.
 */
void DuploHub::staticVoltageSensorCallback(void *hub, byte portNumber, DeviceType deviceType, uint8_t *pData)
{
    static float lastVoltage = -1.0f;

    myLegoHub *myHub = (myLegoHub *)hub;
    if (deviceType == DeviceType::VOLTAGE_SENSOR)
    {
        float detectedVoltage = (float)myHub->parseVoltageSensor(pData);
        if (abs(lastVoltage - detectedVoltage) > VOLTAGE_THRESHOLD)
        { // Only report significant voltage changes
            DEBUG_LOG("(%ld) Static Voltage Callback - Last Voltage: %.2f , Detected Voltage: %.2f", millis(), lastVoltage, detectedVoltage);
            lastVoltage = detectedVoltage;

            // Access the singleton instance to get the response queue
            if (instance != nullptr && instance->responseQueue != nullptr)
            {
                HubResponse response;
                response.type = ResponseType::Detected_Voltage;
                response.data.voltageResponse.detectedVoltage = detectedVoltage;

                if (xQueueSend(instance->responseQueue, &response, pdMS_TO_TICKS(100)) != pdTRUE)
                {
                    DEBUG_LOG("WARNING: Failed to queue voltage sensor response from static callback");
                }
            }
            else
            {
                DEBUG_LOG("ERROR: Cannot access response queue from static voltage callback");
            }
        }
    }
    else
    {
        DEBUG_LOG("ERROR: Unsupported device type for voltage sensor callback");
    }
}

/**
 * @brief List all device ports for the Duplo Train hub.
 */
void DuploHub::listDevicePorts()
{
    DEBUG_LOG("Listing Duplo Train device ports:");
    DEBUG_LOG("Motor Port: %d", (int)hub.getPortForDeviceType((byte)DuploEnums::DuploTrainDeviceType::DUPLO_TRAIN_BASE_MOTOR));
    DEBUG_LOG("Speaker Port: %d", (int)hub.getPortForDeviceType((byte)DuploEnums::DuploTrainDeviceType::DUPLO_TRAIN_BASE_SPEAKER));
    DEBUG_LOG("Color Sensor Port: %d", (int)hub.getPortForDeviceType((byte)DuploEnums::DuploTrainDeviceType::DUPLO_TRAIN_BASE_COLOR_SENSOR));
    DEBUG_LOG("Speed Sensor Port: %d", (int)hub.getPortForDeviceType((byte)DuploEnums::DuploTrainDeviceType::DUPLO_TRAIN_BASE_SPEEDOMETER));
    DEBUG_LOG("Voltage Port: %d", (int)hub.getPortForDeviceType((byte)DuploEnums::DuploTrainDeviceType::VOLTAGE_SENSOR));
}

/**
 * @brief Set the callback function to be called when the hub connects.
 * @param callback The function to call on connection.
 */
void DuploHub::setOnConnectedCallback(ConnectionCallback callback)
{
    onConnectedCallback = callback;
    DEBUG_LOG("DuploHub: OnConnected callback set");
}

/**
 * @brief Set the callback function to be called when the hub disconnects.
 * @param callback The function to call on disconnection.
 */
void DuploHub::setOnDisconnectedCallback(ConnectionCallback callback)
{
    onDisconnectedCallback = callback;
    DEBUG_LOG("DuploHub: OnDisconnected callback set");
}

/**
 * @brief Set the callback function for detected color events.
 * @param callback The function to call when a color is detected.
 */
void DuploHub::setDetectedColorCallback(DetectedColorCallback callback)
{
    detectedColorCallback = callback;
    DEBUG_LOG("DuploHub: DetectedColor callback set");
}

/**
 * @brief Set the callback function for detected speed events.
 * @param callback The function to call when a speed is detected.
 */
void DuploHub::setDetectedSpeedCallback(DetectedSpeedCallback callback)
{
    detectedSpeedCallback = callback;
    DEBUG_LOG("DuploHub: DetectedSpeed callback set");
}

/**
 * @brief Set the callback function for detected voltage events.
 * @param callback The function to call when a voltage is detected.
 */
void DuploHub::setDetectedVoltageCallback(DetectedVoltageCallback callback)
{
    detectedVoltageCallback = callback;
    DEBUG_LOG("DuploHub: DetectedVoltage callback set");
}

/**
 * @brief Start the BLE task on core 0 (if not already running).
 */
void DuploHub::startBLETask()
{
    if (bleTaskHandle == nullptr)
    {
        BaseType_t result = xTaskCreatePinnedToCore(
            bleTaskWrapper, // Task function
            "BLE_Task",     // Name
            4096,           // Stack size (4KB)
            this,           // Parameter (this instance)
            2,              // Priority (higher than main loop)
            &bleTaskHandle, // Task handle
            0               // CPU core 0
        );

        if (result == pdPASS)
        {
            DEBUG_LOG("DuploHub: BLE task started successfully");
        }
        else
        {
            DEBUG_LOG("ERROR: Failed to start BLE task");
            bleTaskHandle = nullptr;
        }
    }
    else
    {
        DEBUG_LOG("WARNING: BLE task is already running");
    }
}

/**
 * @brief Stop the BLE task if it is running.
 */
void DuploHub::stopBLETask()
{
    if (bleTaskHandle != nullptr)
    {
        vTaskDelete(bleTaskHandle);
        bleTaskHandle = nullptr;
        DEBUG_LOG("DuploHub: BLE task stopped");
    }
}

/**
 * @brief Check if the BLE task is currently running.
 * @return True if running, false otherwise.
 */
bool DuploHub::isBLETaskRunning()
{
    return bleTaskHandle != nullptr;
}

/**
 * @brief Static wrapper for the BLE task (required for FreeRTOS).
 * @param parameter Pointer to the DuploHub instance.
 */
void DuploHub::bleTaskWrapper(void *parameter)
{
    DuploHub *instance = static_cast<DuploHub *>(parameter);
    instance->bleTaskFunction();
}

/**
 * @brief BLE task function that handles BLE operations and command processing.
 */
void DuploHub::bleTaskFunction()
{
    DEBUG_LOG("BLE Task: Started successfully");

    // Hub acknowledgements (0x82 / 0x47) drive the command pacing, see processCommandQueue().
    hub.setPortAckCallback(staticPortAckCallback);

    unsigned long lastConnectionCheck = 0;
    const unsigned long CONNECTION_CHECK_INTERVAL = 1000; // Check connection every 1 second

    // Supervise this task with the ESP task watchdog: if it hangs (e.g. stuck in a BLE call),
    // the chip resets instead of staying "connected" but unresponsive. The SDK default of 5 s
    // is too tight because a connect attempt alone may block for 5 s plus service discovery.
    esp_err_t wdtErr = esp_task_wdt_init(BLE_TASK_WDT_TIMEOUT_S, true);
    if (wdtErr == ESP_OK)
    {
        wdtErr = esp_task_wdt_add(nullptr);
    }
    if (wdtErr != ESP_OK)
    {
        DEBUG_LOG("WARNING: BLE task watchdog not active (err=%d)", wdtErr);
    }

    while (true)
    {
        esp_task_wdt_reset();

        unsigned long currentTime = millis();

        // Handle BLE operations at regular intervals
        if (currentTime - lastConnectionCheck >= CONNECTION_CHECK_INTERVAL)
        {
            updateBLE();
            lastConnectionCheck = currentTime;
        }

        // Wait for commands (up to COMMAND_WAIT_MS) instead of polling: a queued command is sent
        // immediately, and the task still yields the CPU and comes back for updateBLE().
        processCommandQueue(pdMS_TO_TICKS(COMMAND_WAIT_MS));
    }
}

/**
 * @brief Perform BLE operations, connection management, and callback invocation (runs in BLE task).
 */
void DuploHub::updateBLE()
{
    static bool wasEverConnected = false; // Track if we ever had a connection (BLE task context)
    static bool lastConnected = false;    // Track last connection state for callback
    static unsigned long lastConnectAttemptLog = 0;
    static unsigned long lastScanStartMs = 0;
    static bool scanAttemptActive = false;
    const unsigned long CONNECT_ATTEMPT_LOG_INTERVAL_MS = 10000;
    const uint32_t RECONNECT_SCAN_DURATION_S = 2;
    const unsigned long SCAN_RETRY_INTERVAL_MS = (RECONNECT_SCAN_DURATION_S * 1000UL) + 250UL;

    // Get current BLE states from Lpf2Hub
    bool hubConnected = hub.isConnected();
    bool hubConnecting = hub.isConnecting();
    bool hubDisconnected = !hubConnecting && !hubConnected;

    // Update thread-safe state variables
    updateConnectionState(hubConnected, hubConnecting);

    // The controller is about to sleep: no scans, no reconnects, no connection edge callbacks.
    if (sleepRequested.load())
    {
        scanAttemptActive = false;
        lastScanStartMs = 0;
        lastConnected = hubConnected;
        return;
    }

    // Discovery is throttled so scans are not restarted on every BLE loop iteration.
    if (hubDisconnected)
    {
        const unsigned long now = millis();
        if (now - lastConnectAttemptLog >= CONNECT_ATTEMPT_LOG_INTERVAL_MS)
        {
            if (!wasEverConnected)
            {
                DEBUG_LOG("BLE Task: Attempting initial connection to hub...");
            }
            else
            {
                DEBUG_LOG("BLE Task: Attempting to reconnect to hub...");
            }
            lastConnectAttemptLog = now;
        }

        if (!scanAttemptActive || (now - lastScanStartMs) >= SCAN_RETRY_INTERVAL_MS)
        {
            if (hubMACAddress != "")
            {
                hub.init(hubMACAddress, RECONNECT_SCAN_DURATION_S);
                DEBUG_LOG("BLE Task: Using preferred hub address: %s (scan=%lus)", hubMACAddress.c_str(), RECONNECT_SCAN_DURATION_S);
            }
            else
            {
                hub.init(RECONNECT_SCAN_DURATION_S);
                DEBUG_LOG("BLE Task: Starting discovery scan (scan=%lus)", RECONNECT_SCAN_DURATION_S);
            }

            lastScanStartMs = now;
            scanAttemptActive = true;
        }
    }

    // Once Legoino reports a pending connection, try to complete it immediately.
    if (hubConnecting)
    {
        scanAttemptActive = false;
        hub.connectHub();
        if (hub.isConnected())
        {
            wasEverConnected = true;
            DEBUG_LOG("BLE Task: Connected to HUB");
            DEBUG_LOG("BLE Task: Hub address: %s", hub.getHubAddress().toString().c_str());
            DEBUG_LOG("BLE Task: Hub name: %s", hub.getHubName().c_str());
        }
        else
        {
            DEBUG_LOG("BLE Task: Failed to connect to HUB");
        }
    }

    // The application only sees connection edges, not every periodic BLE status poll.
    if (hubConnected && !lastConnected)
    {
        scanAttemptActive = false;
        DEBUG_LOG("BLE Task: Connection state changed: CONNECTED");
        clearQueues();
        if (onConnectedCallback != nullptr)
        {
            DEBUG_LOG("DuploHub: Calling onConnectedCallback from BLE task...");
            onConnectedCallback();
            DEBUG_LOG("DuploHub: onConnectedCallback finished");
        }
        else
        {
            DEBUG_LOG("DuploHub: onConnectedCallback is nullptr");
        }
    }
    else if (!hubConnected && lastConnected)
    {
        scanAttemptActive = false;
        lastScanStartMs = 0;
        clearQueues();
        DEBUG_LOG("BLE Task: Connection state changed: DISCONNECTED");
        if (onDisconnectedCallback != nullptr)
        {
            DEBUG_LOG("DuploHub: Calling onDisconnectedCallback from BLE task...");
            onDisconnectedCallback();
            DEBUG_LOG("DuploHub: onDisconnectedCallback finished");
        }
        else
        {
            DEBUG_LOG("DuploHub: onDisconnectedCallback is nullptr");
        }
    }
    lastConnected = hubConnected;
}

/**
 * @brief Wait until the hub has announced a device on `port` (runs in BLE task).
 *
 * Right after connecting, the hub sends one "device attached" message per built-in device.
 * Legoino's activatePortDevice()/getPortForDeviceType() need that information and silently do
 * nothing for ports not announced yet, so activation must wait for it.
 *
 * @param port Hub port of the device to activate.
 * @param name Device name for the log message.
 * @return `true` if the device is known; `false` after timeout or disconnect.
 */
bool DuploHub::waitForHubDevice(byte port, const char *name)
{
    const unsigned long start = millis();
    while (hub.getDeviceIndexForPortNumber(port) < 0)
    {
        if (!hub.isConnected() || millis() - start >= DEVICE_ATTACH_TIMEOUT_MS)
        {
            log_e("Hub device '%s' (port 0x%02x) not announced - not activated", name, port);
            return false;
        }
        esp_task_wdt_reset();
        delay(20);
    }
    return true;
}

/**
 * @brief Hub acknowledgement hook (runs in the NimBLE host task).
 *
 * Only the acknowledgement the BLE task is currently waiting for is passed on; everything else
 * (late or unrelated feedback) is ignored.
 */
void DuploHub::staticPortAckCallback(byte port, byte status, bool inputFormat)
{
    if (instance == nullptr || instance->ackSemaphore == nullptr)
    {
        return;
    }
    if (instance->expectedAckPort.load() != (int)port || instance->expectInputFormatAck.load() != inputFormat)
    {
        return;
    }
    instance->lastAckStatus.store(status);
    instance->expectedAckPort.store(-1);
    xSemaphoreGive(instance->ackSemaphore);
}

/**
 * @brief Wait for the hub to acknowledge the command just sent on `port` (BLE task).
 *
 * Called right after the write: the hub needs at least ~40 ms to answer, so the expectation is
 * always registered before the acknowledgement can arrive.
 */
bool DuploHub::waitForAck(byte port, bool inputFormat, uint8_t &status)
{
    status = 0;
    if (ackSemaphore == nullptr)
    {
        delay(COMMAND_PACING_MS); // no handshake possible: fall back to fixed pacing
        return true;
    }

    xSemaphoreTake(ackSemaphore, 0); // drop a stale acknowledgement
    lastAckStatus.store(0);
    expectInputFormatAck.store(inputFormat);
    expectedAckPort.store(port);

    const bool acknowledged = (xSemaphoreTake(ackSemaphore, pdMS_TO_TICKS(ACK_TIMEOUT_MS)) == pdTRUE);
    expectedAckPort.store(-1);
    status = lastAckStatus.load();
    return acknowledged;
}

/**
 * @brief Send one command to the hub (BLE task) and report which acknowledgement to await.
 */
DuploHub::AckExpectation DuploHub::executeCommand(const HubCommand &cmd)
{
    const AckExpectation none = {-1, false};

    switch (cmd.type)
    {
    case CommandType::CMD_MOTOR_SPEED:
        DEBUG_LOG("BLE Task: Setting motor speed to %d", cmd.data.motor.speed);
        hub.setBasicMotorSpeed((byte)DuploEnums::DuploTrainHubPort::MOTOR, cmd.data.motor.speed);
        return {(int)DuploEnums::DuploTrainHubPort::MOTOR, false};

    case CommandType::CMD_STOP_MOTOR:
        DEBUG_LOG("BLE Task: Stopping motor");
        hub.stopBasicMotor((byte)DuploEnums::DuploTrainHubPort::MOTOR);
        return {(int)DuploEnums::DuploTrainHubPort::MOTOR, false};

    case CommandType::CMD_SET_LED_COLOR:
        DEBUG_LOG("BLE Task: Setting LED color to %d", cmd.data.led.color);
        hub.setLedColor((Color)cmd.data.led.color);
        return {(int)DuploEnums::DuploTrainHubPort::LED, false};

    case CommandType::CMD_PLAY_SOUND:
        DEBUG_LOG("BLE Task: Playing sound with ID %d", cmd.data.sound.soundId);
        hub.playSound((byte)cmd.data.sound.soundId);
        return {(int)DuploEnums::DuploTrainHubPort::SPEAKER, false};

    case CommandType::CMD_SET_HUB_NAME:
    {
        // Hub property write: the hub sends no acknowledgement -> fixed pacing.
        DEBUG_LOG("BLE Task: Setting hub name to %s", cmd.data.hubName.name);
        char name[sizeof(cmd.data.hubName.name)];
        memcpy(name, cmd.data.hubName.name, sizeof(name)); // Legoino takes a non-const char*
        name[sizeof(name) - 1] = '\0';
        hub.setHubName(name);
        return none;
    }

    // Activations need the device to be announced by the hub first (see waitForHubDevice()).
    case CommandType::CMD_ACTIVATE_RGB_LIGHT:
        DEBUG_LOG("BLE Task: Activating RGB light");
        if (!waitForHubDevice((byte)DuploEnums::DuploTrainHubPort::LED, "LED"))
            return none;
        hub.activateRgbLight();
        return {(int)DuploEnums::DuploTrainHubPort::LED, true};

    case CommandType::CMD_ACTIVATE_BASE_SPEAKER:
    {
        DEBUG_LOG("BLE Task: Activating base speaker");
        if (!waitForHubDevice((byte)DuploEnums::DuploTrainHubPort::SPEAKER, "speaker"))
            return none;
        // Two port setups on the same port: confirm the first before sending the second.
        hub.activateSpeakerPort();
        uint8_t status = 0;
        if (!waitForAck((byte)DuploEnums::DuploTrainHubPort::SPEAKER, true, status))
        {
            log_e("Hub did not confirm speaker port setup within %u ms", (unsigned)ACK_TIMEOUT_MS);
        }
        hub.setSpeakerSoundMode();
        return {(int)DuploEnums::DuploTrainHubPort::SPEAKER, true};
    }

    case CommandType::CMD_ACTIVATE_COLOR_SENSOR:
        DEBUG_LOG("BLE Task: Activating color sensor");
        if (!waitForHubDevice((byte)DuploEnums::DuploTrainHubPort::COLOR, "color sensor"))
            return none;
        hub.activatePortDevice((byte)DuploEnums::DuploTrainHubPort::COLOR, staticColorSensorCallback);
        if (COLOR_SENSOR_MODE != 0)
        {
            // Legoino activates mode 0 (COLOR); after the hub confirmed it, switch to the configured
            // mode. The callback stays registered for the port.
            uint8_t status = 0;
            if (!waitForAck((byte)DuploEnums::DuploTrainHubPort::COLOR, true, status))
            {
                log_e("Hub did not confirm color sensor setup within %u ms", (unsigned)ACK_TIMEOUT_MS);
            }
            hub.setColorSensorMode(COLOR_SENSOR_MODE);
        }
        return {(int)DuploEnums::DuploTrainHubPort::COLOR, true};

    case CommandType::CMD_ACTIVATE_SPEED_SENSOR:
        DEBUG_LOG("BLE Task: Activating speed sensor");
        if (!waitForHubDevice((byte)DuploEnums::DuploTrainHubPort::SPEEDOMETER, "speed sensor"))
            return none;
        hub.activatePortDevice((byte)DuploEnums::DuploTrainHubPort::SPEEDOMETER, staticSpeedSensorCallback);
        return {(int)DuploEnums::DuploTrainHubPort::SPEEDOMETER, true};

    case CommandType::CMD_ACTIVATE_VOLTAGE_SENSOR:
        DEBUG_LOG("BLE Task: Activating voltage sensor");
        if (!waitForHubDevice((byte)DuploEnums::DuploTrainHubPort::VOLTAGE, "voltage sensor"))
            return none;
        hub.activatePortDevice((byte)DuploEnums::DuploTrainHubPort::VOLTAGE, staticVoltageSensorCallback);
        return {(int)DuploEnums::DuploTrainHubPort::VOLTAGE, true};

    default:
        DEBUG_LOG("BLE Task: Unknown command type");
        return none;
    }
}

/**
 * @brief Process commands from the command queue (runs in BLE task).
 *
 * Waits up to `firstWait` for the first command, then drains the queue. After each command the
 * task waits for the hub's acknowledgement for that port (typically 40-110 ms) before sending the
 * next one; the hub silently drops commands that arrive while it is still busy. A command the hub
 * reports as discarded is sent once more. Without acknowledgement (timeout, or commands the hub
 * never acknowledges) the fixed `COMMAND_PACING_MS` applies.
 *
 * @param firstWait Maximum time to block for the first command.
 */
void DuploHub::processCommandQueue(TickType_t firstWait)
{
    if (commandQueue == nullptr)
        return;

    HubCommand cmd;
    TickType_t wait = firstWait;

    while (xQueueReceive(commandQueue, &cmd, wait) == pdTRUE)
    {
        wait = 0; // drain the rest without blocking

        // Sleep preparation must always be acknowledged, even if the hub is already gone.
        if (cmd.type == CommandType::CMD_STOP_AND_DISCONNECT)
        {
            if (hub.isConnected())
            {
                DEBUG_LOG("BLE Task: Stopping motor and disconnecting before sleep");
                hub.stopBasicMotor((byte)DuploEnums::DuploTrainHubPort::MOTOR);
                uint8_t status = 0;
                waitForAck((byte)DuploEnums::DuploTrainHubPort::MOTOR, false, status); // stop out before closing
                hub.disconnectHub();
                delay(100);
            }
            linkShutdownComplete.store(true);
            continue;
        }

        // Commands are dropped while disconnected because replaying stale writes would be unsafe.
        if (!hub.isConnected())
        {
            DEBUG_LOG("BLE Task: Skipping command - hub not connected");
            continue;
        }

        for (int attempt = 0; attempt < 2; attempt++)
        {
            const AckExpectation ack = executeCommand(cmd);
            if (ack.port < 0)
            {
                delay(COMMAND_PACING_MS);
                break;
            }

            uint8_t status = 0;
            if (!waitForAck((byte)ack.port, ack.inputFormat, status))
            {
                log_e("Hub did not acknowledge command %d on port 0x%02x within %u ms",
                      (int)cmd.type, ack.port, (unsigned)ACK_TIMEOUT_MS);
                break; // already waited the full timeout; continue with the next command
            }
            if (!ack.inputFormat && (status & 0x04))
            {
                log_e("Hub discarded command %d on port 0x%02x - sending again", (int)cmd.type, ack.port);
                continue;
            }
            break;
        }
    }
}

/**
 * @brief Stop the motor and close the BLE link before the controller sleeps.
 * @param timeoutMs Maximum time to wait for the BLE task to confirm.
 * @return `true` if the BLE task confirmed stop + disconnect in time.
 */
bool DuploHub::shutdownLinkForSleep(uint32_t timeoutMs)
{
    linkShutdownComplete.store(false);
    sleepRequested.store(true);

    if (commandQueue == nullptr)
    {
        return false;
    }

    // Pending UI commands are irrelevant now; the stop must not wait behind them.
    xQueueReset(commandQueue);

    // Bypass sendCommand() so this internal command is never recorded for replay.
    HubCommand cmd = createHubCommand(CommandType::CMD_STOP_AND_DISCONNECT);
    if (xQueueSend(commandQueue, &cmd, pdMS_TO_TICKS(100)) != pdTRUE)
    {
        DEBUG_LOG("WARNING: Failed to queue stop-and-disconnect command");
        return false;
    }

    const unsigned long start = millis();
    while (!linkShutdownComplete.load() && (millis() - start) < timeoutMs)
    {
        vTaskDelay(pdMS_TO_TICKS(10));
    }
    return linkShutdownComplete.load();
}

/**
 * @brief Re-enable scanning and reconnects after a sleep that returned (light sleep).
 */
void DuploHub::resumeAfterSleep()
{
    linkShutdownComplete.store(false);
    sleepRequested.store(false);
}

/**
 * @brief Process all responses from the response queue and invoke registered callbacks.
 */
void DuploHub::processResponseQueue()
{
    if (responseQueue == nullptr)
        return;

    HubResponse response;

    // Process all available responses (non-blocking)
    while (xQueueReceive(responseQueue, &response, 0) == pdTRUE)
    {
        switch (response.type)
        {
        case Detected_Color:
            DEBUG_LOG("Detected Color: %d", response.data.colorResponse.detectedColor);
            if (detectedColorCallback != nullptr)
            {
                detectedColorCallback(response.data.colorResponse.detectedColor);
                DEBUG_LOG("Detected Color Callback executed");
            }
            break;

        case Detected_Speed:
            DEBUG_LOG("Detected Speed: %d", response.data.speedResponse.detectedSpeed);
            if (detectedSpeedCallback != nullptr)
            {
                detectedSpeedCallback(response.data.speedResponse.detectedSpeed);
                DEBUG_LOG("Detected Speed Callback executed");
            }
            break;

        case Detected_Voltage:
            DEBUG_LOG("Detected Voltage: %.2f V", response.data.voltageResponse.detectedVoltage);
            if (detectedVoltageCallback != nullptr)
            {
                detectedVoltageCallback(response.data.voltageResponse.detectedVoltage);
                DEBUG_LOG("Detected Voltage Callback executed");
            }
            break;

        default:
            DEBUG_LOG("Unknown response type");
            break;
        }
    }
}

/**
 * @brief Clear all pending commands and responses in the command and response queues.
 */
void DuploHub::clearQueues()
{
    if (commandQueue != nullptr)
    {
        HubCommand cmd;
        while (xQueueReceive(commandQueue, &cmd, 0) == pdTRUE)
        {
            // Drop stale commands when the hub state changes.
        }
    }
    if (responseQueue != nullptr)
    {
        HubResponse response;
        while (xQueueReceive(responseQueue, &response, 0) == pdTRUE)
        {
            // Drop stale sensor notifications from a previous connection state.
        }
    }
}
