kleieg/Duplo_Zug/(commit log)

2026-03-08 Stabilize controller inputs and replay handling
    [ADCButton.cpp, ADCButton.h, DuploHub.cpp, TrainController.cpp, debug.cpp]
2026-03-08 Update hardware case and PCB assets
    [5 Buttons an ADC.xlsx, Controller-V1.5.3mf, Controller-V1.5.scad, Controller.3mf, Controller.scad, Controller.stl, DuploTrainController NG.kicad_pcb, DuploTrainController NG.kicad_sch]
2026-03-09 Aktualisierung der Dokumentation
    [DuploTrainController NG.csv]
2026-03-19 Alle Hardware Änderungen commited. Cae ist jetzt bezüglich der Ausbrüche für Knöpfe etwas vergrößert worde und die PAssung für den Drehknopf wurde etwas enger gemacht für besseren Halt
    [5 Buttons an ADC.xlsx, Controller-V1.5-Duplo.3mf, Controller-V1.5-Knöpfe-1.3mf, Controller-V1.5-Knöpfe-2.3mf, Controller-V1.5.scad]
2026-03-19 Commit current project state
2026-11-06 Fix encoder, sleep, emergency stop, cross-core and low-voltage issues
    - Encoder: callback only stores the value; main loop applies it with a
    trailing-edge rate limit so fast turns are no longer lost, and no
    delay() runs in the esp_timer task anymore.
    - Sleep: end record/replay, stop the motor and disconnect the hub
    (new CMD_STOP_AND_DISCONNECT + myLegoHub::disconnectHub) before
    sleeping; replay counts as activity; disconnect ends a stale replay.
    - Color tiles are ignored during emergency stop; e-stop and RED reset
    lastSpeed; GREEN and replay keep the knob in sync.
    - Connect/disconnect callbacks from the BLE task only set atomic flags;
    UI/LED handling moved to loop().
    - Low-voltag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
    [DuploHub.cpp, DuploHub.h, TrainController.cpp, myLegoHub.cpp, myLegoHub.h]
2026-11-06 Remove dead DuploHub code left over from the 2025 refactoring
    - update()/ensureBLETaskRunning(): uncalled since 7c8c4bb; the handle
    check could never detect a hung or crashed BLE task anyway.
    - wasConnected, replayCycle, sequenceDuration, DuploHub(byte port),
    setMotorPort()/getMotorPort() (motor always on MOTOR port) and the
    never-implemented playSoundDirect() declaration.
    - Null-queue direct-hub fallbacks (unreachable, not thread-safe) now
    log an error like the other commands.
    - Constructor initializer list in declaration order, responseQueue
    now explicitly initialized.
    - CHANGELOG: note that the 2.0 migration example's update() is gone.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
    [DuploHub.cpp, DuploHub.h]
2026-11-06 Supervise BLE task with the ESP task watchdog
    Replaces the removed, ineffective ensureBLETaskRunning() handle check.
    The BLE task subscribes to the task watchdog and feeds it every loop
    iteration; the timeout is raised from the SDK default of 5 s to 15 s
    because a connect attempt can block for 5 s plus service discovery.
    The boot log now shows the reset reason (6 = task watchdog).
    [DuploHub.cpp, TrainController.cpp]
2026-11-06 DuploHub: single enqueue helper, replay re-queues recorded commands
    - queueCommand() replaces ten copies of the null-check/send/log block.
    - replayCommand() queues a recorded HubCommand as-is; TrainController no
    longer duplicates the command switch for replay.
    - Queue lengths are named constants (fixes the stale '10 entries'
    comment on the 100-entry response queue).
    [DuploHub.cpp, DuploHub.h, TrainController.cpp]
2026-11-06 TrainController: drop blocking UI delays, name constants, sound order
    - Remove the delay(DELAY_TIME) calls in button and color handlers. They
    only blocked the main loop (STOP: ~400 ms); spacing between hub writes
    is already done by the BLE task (20-200 ms per command).
    - HUB_NAME constant instead of an inline string.
    - Sound button now starts with HORN (index was advanced before playing).
2026-11-06 ADCButtons: per-instance sampling state, single resize routine
    - Sampling state moved from function-local statics into members, so
    several ADCButtons instances no longer share (and corrupt) one buffer
    index/timer.
    - ensureCapacity() replaces two copies of the table-resize code
    (addButton's copy also left adcMin/adcMax uninitialized).
    - Sample buffer is allocated with the validated sample count (was the
    raw constructor argument).
    - Removed write-only bufferFilled flag.
    [ADCButton.cpp, ADCButton.h]
2026-11-06 Repo housekeeping: shared PlatformIO env, untrack generated files, CI build
    - platformio.ini: shared [env] section; drop machine-specific
    upload/monitor ports (auto-detect; override with --upload-port).
    - Stop tracking .DS_Store, KiCad auto-backup zips and fp-info-cache;
    ignore them going forward (files stay on disk and in history).
    - GitHub Actions workflow builds both PlatformIO environments.
    - CHANGELOG entries for this cleanup round.
2026-11-06 Status LED: steady red only for emergency stop, mode is restored after bursts
    - RED track brick shows a 3x red burst like the other bricks; steady red
    now means emergency stop only.
    - updateModeIndication() is the single place that shows the current mode
    (e-stop, replay, recording, initializing) whenever no burst plays, so
    e.g. the e-stop red comes back after disconnect, wake or warnings.
    - StatusLED::isBurstActive(); heartbeat and low-voltage bursts wait
    instead of cutting off other bursts.
    - StatusLED bursts now run N full on/off cycles (last blink was cut to
    one loop cycle).
    - RECORD and PLAY are ignored during emergency stop.
    - E-stop and RED brick queue the motor stop before s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
2026-11-06 Inputs: one speed step per encoder click, faster button detection
    - ENCODER_STEPS_PER_DETENT 8 -> 4: the library needs that many quadrature
    edges per value change, so 8 required two clicks per step. Comment
    corrected (it claimed the opposite).
    - ADCButtons with 4 instead of 10 samples (settling + averaging), so a
    press registers after ~0.2 s instead of ~0.5 s.
    [TrainController.cpp]
2026-11-06 Encoder: skip the stop zone below MIN_SPEED
    The first click from standstill now starts the train at +/-MIN_SPEED
    (previously +/-5 fell into the stop zone and nothing happened); the next
    click down from +/-MIN_SPEED stops it. The knob value follows, so every
    click changes the speed. A fixed MIN_SPEED was chosen over an adaptive
    ramp based on the speed sensor (coarse, delayed, and it would push power
    up if a child holds the train).
    [TrainController.cpp]
2026-11-06 Encoder: MIN_SPEED 10 -> 20 (measured minimum to move the train)
2026-11-06 Remove startup upload mode
    Uploads work via USB auto-reset while the controller is awake; the 2 s
    encoder hold at boot (10 s upload window) is no longer needed. From
    sleep, wake with the encoder button first; BOOT+RESET stays the ROM
    recovery path. Docs updated.
    [TrainController.cpp]
2026-11-06 Dial button: press = normal stop, hold 2 s = sleep now
    - Press (debounced, acts immediately): stop motor, end replay, knob to 0.
    Nothing is locked; STOP stays the latching emergency stop. Ignored
    while not ready or during emergency stop.
    - Hold 2 s: fast red blinking, sleep is entered on release (sleeping while
    held would immediately trigger the LOW-level wake again).
    - The press that woke the controller (deep or light sleep) is ignored
    until released.
    - Encoder button pin is a plain digital input at runtime (rtc_gpio_deinit);
    the RTC/EXT1 wake configuration is applied only right before sleeping.
    - User Manual, README, ARCHITECTURE and CHANGELOG updated.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
2026-11-06 STOP button: plain stop, same as dial press; remove emergency stop
    STOP now calls normalStop(): motor stop, end replay, knob to 0, silent,
    nothing locked. Removed the emergencyStop state and everything tied to
    it: steady red LED mode, brake sound/red train light on STOP, ignoring
    dial, color bricks, RECORD/PLAY and replayed commands. A running
    recording continues and records the stop. Docs updated.
2026-11-06 Buttons: 3 samples for settling/averaging (~120-150 ms per press)
2026-11-06 Encoder: MIN_SPEED 20 -> 25 (20 did not move the train reliably)
2026-11-06 Sync target speed with the hub's built-in safety stop
    The DUPLO hub cuts the motor when the train is blocked, lifted or pressed
    down, but the controller kept its target speed, so the next dial click
    resumed from the old value. If the train was seen moving after the last
    target change and then reports speed 0 (>= 1 s after the change, not
    during replay), the controller sends a stop and resets target and knob
    to 0. The grace time covers start-up and passing through 0 on direction
    changes; if the sensor never reports movement at very low speed, nothing
    is triggered.
    [TrainController.cpp]
2026-11-06 Encoder: read the dial with the hardware pulse counter (PCNT)
    Occasional lost clicks at any speed came from lost quadrature edges in
    the interrupt-based ESP32RotaryEncoder library (one lost edge = one lost
    click, since it resets its step counter after each step).
    New PcntEncoder module (legacy driver/pcnt.h, available on
    espressif32@6.4.0): x4 quadrature decoding in hardware with glitch
    filter, polled from the main loop (no ISR / esp_timer callback). A click
    counts after 3 of its 4 edges, and the detent reference re-aligns after
    300 ms at rest, so single lost edges neither lose a click nor
    accumulate. Same interface as before (setEncoderValue/getEncoderValue,
    +/-100, step 5); DIAL_DIRECTION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
    [PcntEncoder.cpp, PcntEncoder.h, TrainController.cpp]
2026-11-06 Reset target speed when the train stands still for 1 s
    Replaces the callback rule (which needed the train to have moved first)
    with one time-based check in the main loop: target != 0 while the last
    reported speed is 0 for STALL_RESET_MS (1 s) -> stop, target and knob to
    0. Covers the hub's safety stop while driving and a blocked train that
    never gets going. A new target restarts the timer; only active after the
    speed sensor reported at least once; not during replay. detectedSpeed is
    reset on disconnect.
    [TrainController.cpp]
2026-11-06 Stop sync: react to the sensor's 0 report instead of waiting 1 s
    - An unexpected 0 speed report while a target is set resets target and
    knob immediately (hub safety stop: blocked, lifted, pressed down).
    - noteTargetSpeed() marks one 0 report as expected when our own command
    passes through 0 (direction change while moving, GREEN/BLUE bricks);
    the expectation expires after 1.5 s.
    - A train that never starts sends no report: start timeout of 1 s for
    drive commands from standstill (only once the sensor has reported).
    - Speedometer dead zone 10 -> 5 (= reporting threshold), so a slowly
    starting train is not reported as 0.
    [TrainController.cpp, myLegoHub.cpp]
2026-11-06 Docs housekeeping: update ARCHITECTURE.md, drop Refactorings.md, reset ToDo.md
    - ARCHITECTURE.md reflects the current design: plain stop, dial button,
    PCNT encoder, ADC timing, stop sync with the hub safety stop, LED
    mode/burst model, sleep/wake flow, BLE task watchdog, modules and the
    Arduino-ESP32 2.x constraint of the vendored Legoino/NimBLE.
    - Refactorings.md removed: the Legoino facade consolidation was dropped
    (all Legoino calls already live in DuploHub.cpp).
    - ToDo.md reset to an empty list.
2026-11-06 Fix boot hang on battery: no Serial.flush() on USB-CDC
    On battery (no USB host) the controller stopped in setup() with a
    steady yellow LED. HWCDC::flush() in this Arduino-ESP32 version loops
    until a host has read all output; without USB nobody reads. Triggered
    since debug output (Serial.begin) was enabled in TrainController.cpp
    (faa0fb4); DuploHub::init() calls Serial.flush() during setup.
    - removed all Serial.flush() calls (DuploHub x5, before sleep)
    - Serial.setTxTimeoutMs(2): writes never wait long without a host
    [DuploHub.cpp, TrainController.cpp]
2026-11-06 Status LED: short blue flash while searching for the train
    After boot the LED was off until a train connected, so searching looked
    like a switched-off controller. New LED mode Searching (no train
    connected): 100 ms blue every 1.5 s, distinct from the fast blue blinking
    while initializing. Priority below replay/recording. Docs updated.
    [TrainController.cpp]
2026-11-06 README: LED list with searching flash, white/red bursts
2026-11-06 Status LED: steady white during boot (yellow blinking = replay only)
    Boot was shown as yellow (effectively steady, since the LED is only
    animated from loop()), which collided with yellow blinking for replay.
    Boot is now steady white, the only steady color. Docs updated.
    [TrainController.cpp]
2026-11-06 Status LED: violet for recording/replay, yellow for low battery
    - recording: steady violet; replay: blinking violet (was yellow blinking)
    - low-battery warning: 5x fast yellow (was red)
    - README: color brick table including the controller LED bursts; LED
    list updated; stale upload-mode control line removed
    - User Manual, ARCHITECTURE, CHANGELOG updated
2026-11-06 Add TILE_ACTIONS switch to disable the controller's color tile reactions
    With TILE_ACTIONS 0 detected colors are only logged and nothing is sent
    to the train, to observe whether the hub reacts to tiles on its own while
    connected. Default 1 (unchanged behavior).
2026-11-06 Color tiles: react fast and reliably; real water stop; no fixed BLE delays
    Tiles were missed or handled too late (GREEN passed or ping-pong,
    BLUE barely stopped). Controller-side latency of ~0.5-0.6 s:
    - color debounce 250 ms -> 80 ms (tile registered at full speed)
    - tile handlers send the motor command first, sound/LED after
    - BLE task waits on the command queue instead of polling every 50 ms
    - fixed 200 ms (LED/sound/activation) and 20 ms (motor) pauses replaced
    by a uniform 20 ms pacing; Lpf2Hub::WriteValue() now retries writes
    the BLE stack rejects (was silently lost) and returns success
    Tile behavior (the hub does nothing on its own while connected):
    - GREEN: reverse directly (no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
    [DuploHub.cpp, DuploHub.h, TrainController.cpp]
2026-11-06 Activate hub devices only after the hub announced them
    After connecting, the hub announces its built-in devices one by one.
    Lpf2Hub::activatePortDevice() / getPortForDeviceType() silently do
    nothing for ports not announced yet. The removed 200 ms pauses had
    delayed sensor activation enough to hide this race; without them the
    color sensor was activated too early and never reported.
    The BLE task now waits (20 ms polling, max 2 s, watchdog fed) until the
    LED, speaker, color, speed and voltage devices are announced before
    activating them, and logs an error if one never appears.
    [DuploHub.cpp, DuploHub.h]
2026-11-06 Keep 200 ms pause after the one-time device activations
    Hardware log after 96dc33d: voltage sensor reported, color and speed
    sensor stayed silent; no write errors, no missing-device errors. The
    color and speed activations followed the speaker's two writes within
    ~20-40 ms, the voltage activation came later. The hub evidently drops a
    port setup that arrives too soon after the previous one.
    Activation commands (LED, speaker, color, speed, voltage; once per
    connection) are again followed by 200 ms; all runtime commands keep the
    20 ms pacing.
    [DuploHub.cpp]
2026-11-06 Reliable hub commands: 200 ms pacing, ignore non-action colors
    Hardware log: on a BLUE tile the stop command was lost (speed reports
    stayed ~50 during the whole water stop); other runs lost the sound or
    both. The DUPLO hub drops commands that arrive within ~20 ms of each
    other, while the BLE stack reports success.
    - COMMAND_PACING_MS 20 -> 200 for all commands (replaces the separate
    activation pacing). Tile handlers send the motor command first, so
    only the following sound/LED commands wait.
    - BLACK and other non-action colors no longer send a train light
    command; with the 80 ms debounce track gaps triggered them constantly
    and flooded the queue.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
    [DuploHub.cpp, TrainController.cpp]
2026-11-06 Diagnostics: log LWP command TX and hub feedback (0x82/0x47)
    LWP_FEEDBACK_DIAG (Lpf2Hub.cpp, default 1 for the test): every command
    written to the hub is printed with a millisecond timestamp, as are the
    hub's Port Output Command Feedback (0x82, with decoded status bits) and
    Port Input Format (0x47) messages. Logging only, no behavior change.
    Purpose: check whether the DUPLO hub acknowledges motor/sound/LED
    commands reliably enough for feedback-based pacing.
2026-11-06 Pace hub commands by the hub's acknowledgements
    Diagnostics showed the DUPLO hub acknowledges every port command
    (Port Output Command Feedback 0x82 after 44-75 ms) and every port setup
    (Port Input Format 0x47 after 72-112 ms). Commands sent before that
    acknowledgement were the ones it dropped.
    - Legoino: parsePortAction() (was empty) and the 0x47 message are
    forwarded via setPortAckCallback() (project-local change).
    - DuploHub: executeCommand() sends one command and names the expected
    acknowledgement; processCommandQueue() waits for it (binary semaphore,
    timeout 250 ms) and resends once if the hub reports 'discarded'.
    Commands without acknowledgement (hub name) keep the fixed 200 ms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
    [DuploHub.cpp, DuploHub.h, myLegoHub.cpp, myLegoHub.h]
2026-11-06 Fix build: copy hub name before passing it to Legoino's setHubName(char*)
    executeCommand() takes the command as const; Lpf2Hub::setHubName() needs a
    non-const char*.
    [DuploHub.cpp]
2026-11-07 Color tiles: only while driving; GREEN without standstill start; C TAG test
    Kids testing showed random tile reactions in the air, on carpet and on
    stone floor.
    - Movement gate: a color only triggers an action if a target speed is
    set AND the speed sensor reports movement (standing, lifted, pushed by
    hand and water-stop pauses are ignored). The detected color is still
    logged before the gate.
    - GREEN reverses only a moving train; the standstill branch (fixed -40,
    always the same direction) is removed.
    - COLOR_SENSOR_MODE (DuploHub.cpp) = 1: after Legoino's mode-0 activation
    is confirmed, the color sensor is switched to mode 1 "C TAG" (same
    8-bit color index format). Under evaluati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
    [DuploHub.cpp, TrainController.cpp, myLegoHub.cpp, myLegoHub.h]
2026-11-07 Diagnostics: raw color sensor messages and debounce emit/suppress log
    COLOR_RAW_DIAG (DuploHub.cpp, true for the test): prints every color
    sensor notification (raw bytes, parsed color) and whether the debounce
    emits a stable color or suppresses it as identical to the last stable
    one. Purpose: find out why the same tile color is not detected twice in
    a row in C TAG mode (hub latching vs. our same-color filter).
2026-11-07 C TAG: pass tile events on immediately, no debounce
    Raw sensor log: in C TAG mode the hub sends exactly one event per tile
    (tile color, then 0xff ~1 ms later) and nothing in between. The 0xff
    was discarded before the debounce, so 'last stable color' stayed at the
    tile color and a second tile of the same color was suppressed.
    C TAG events (0-10) now go to the response queue immediately, without
    the stability timer and the same-color filter; 0xff is ignored. The
    COLOR mode keeps its debounce. Raw diagnostics off by default.
    [DuploHub.cpp]
2026-11-07 Push to start: a pushed standing train starts in the push direction
    If the train has been standing without target for >= 1 s (speed sensor
    reported 0) and the sensor then reports >= 10, the controller sets the
    target to +/-MIN_SPEED in the push direction (sensor sign = motor sign),
    sends it and syncs the knob. The arming time prevents a train still
    rolling out after a stop from restarting. Not during replay; cancels a
    running water stop; counts as user activity.
    [TrainController.cpp]
2026-11-07 Push to start: small speed reports must not disarm
    The first speed reports of a gentle push are small (< 10). They counted
    as 'moving', reset the arming timer and were below the push threshold,
    so the following larger report found the start disarmed; it only
    re-armed after another 0 report. Speeds below PUSH_START_MIN_SPEED now
    count as standing (arming continues); only a report >= the threshold is
    evaluated as a push.
    [TrainController.cpp]
2026-11-07 Push to start: any measured movement counts (threshold 10 -> 1)
    A threshold of 10 needed too strong a push. The sensor only reports
    changes > 5 raw anyway; rolling out after a stop stays covered by the
    1 s arming time.
2026-11-07 WATER button: same water stop as the BLUE tile
    The WATER button only ever played the water sound; the BLUE tile has the
    full water stop. The tile logic moved into startWaterStop(), used by
    both: while driving stop, water sound, continue after WATER_STOP_MS
    (cancelled by dial, STOP, push or another tile); standing only sound
    and LED. Docs updated.
2026-11-07 Push to start: no wait after standstill (PUSH_START_ARM_MS 1000 -> 0)
    The 1 s wait made pushing right after a stop feel unresponsive. Rolling
    out after a stop is already covered by requiring a standstill (speed
    report 0) first; no spring-back observed on hardware. The constant stays
    to add a wait if ever needed.
