kleieg/Duplo_Zug/(notices)

Notices in the files:
hardware/DuploTrainController NG/DuploTrainController NG.kicad_pcb:
V1.0 R. Zuehlsdorff © 2026
